pegasus0069/CogniLink/cognilink-journal-overleaf paper contents/figures/fig5e_hid_report_intervals.png

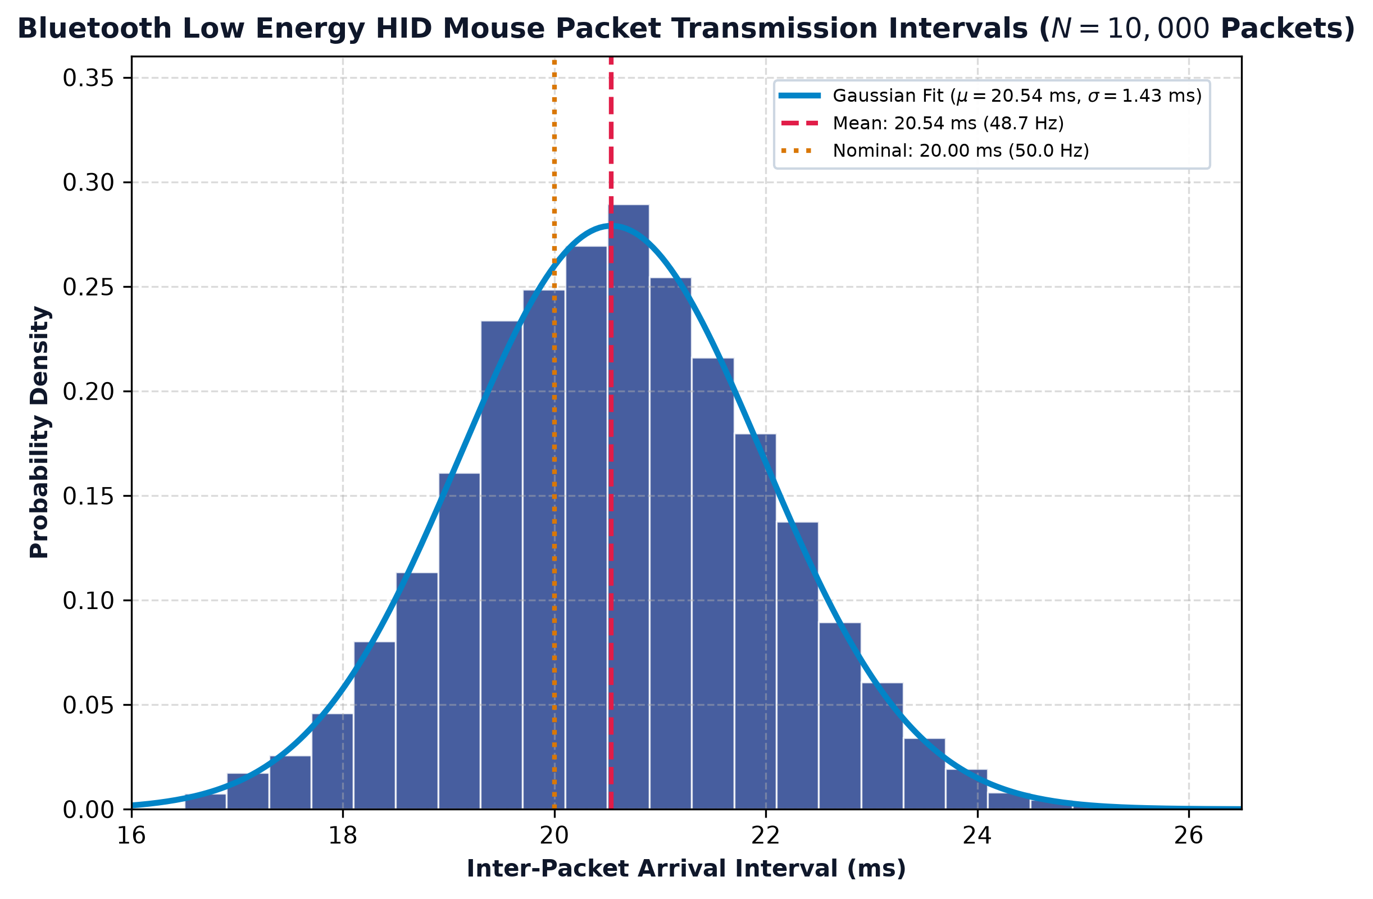
cognilink-journal-overleaf paper contents/figures/fig5e_hid_report_intervals.png
