pegasus0069/CogniLink/figures/assets/fig2_hardware_architecture_master.png

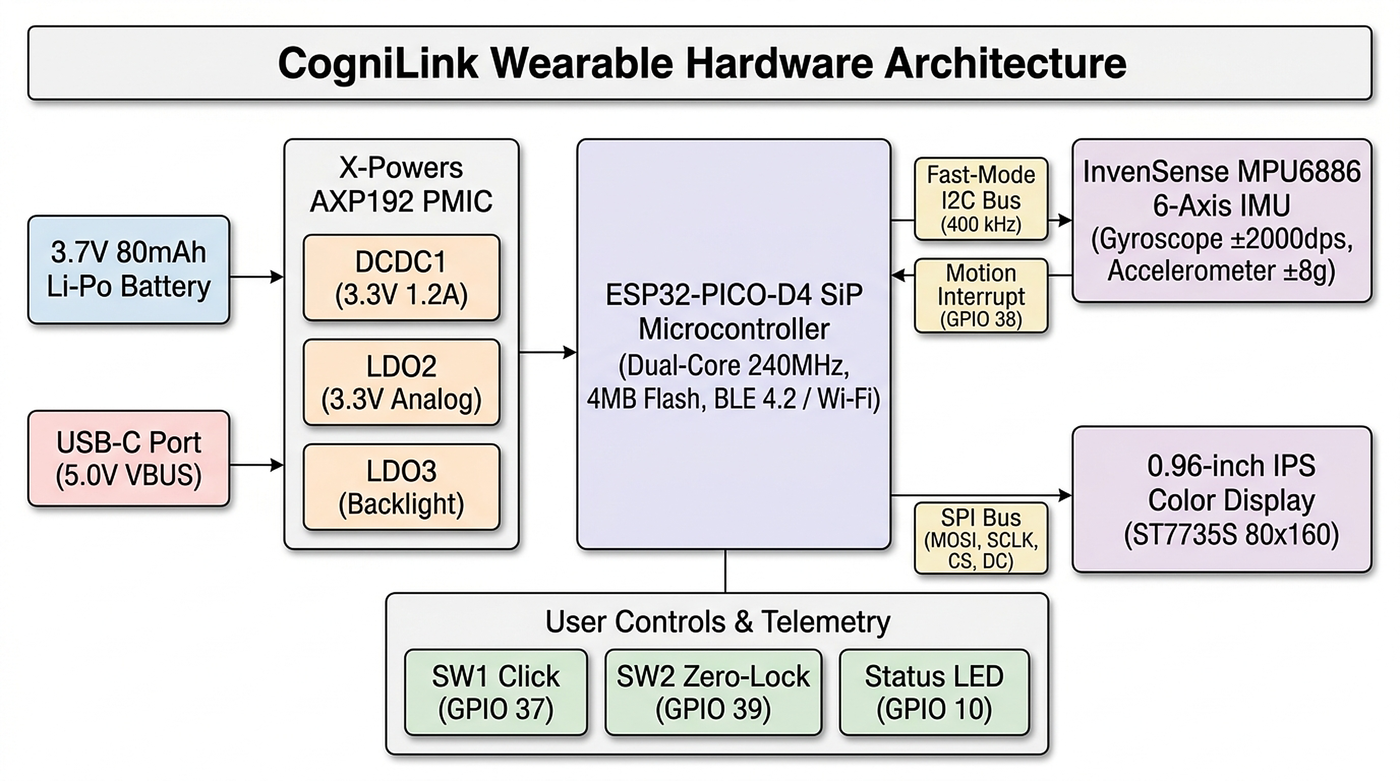
figures/assets/fig2_hardware_architecture_master.png
