pegasus0069/CogniLink/figures/assets/scratch_art_a.png

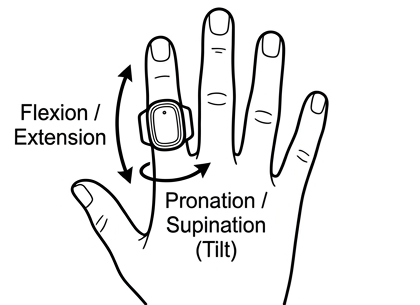
figures/assets/scratch_art_a.png
