pegasus0069/CogniLink/figures/assets/scratch_art_b.png

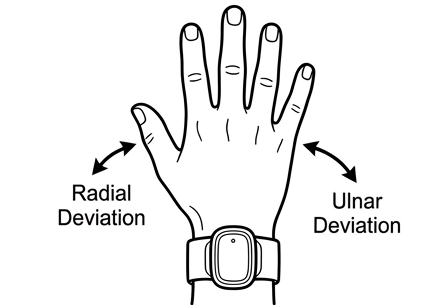
figures/assets/scratch_art_b.png
