pegasus0069/CogniLink/figures/assets/scratch_art_c.png

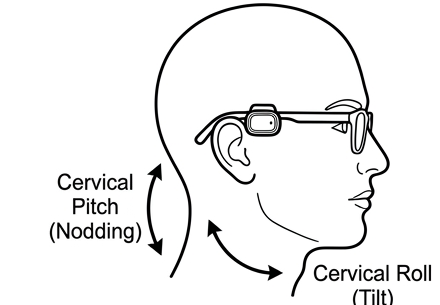
figures/assets/scratch_art_c.png
