pegasus0069/CogniLink/figures/assets/scratch_art_d.png

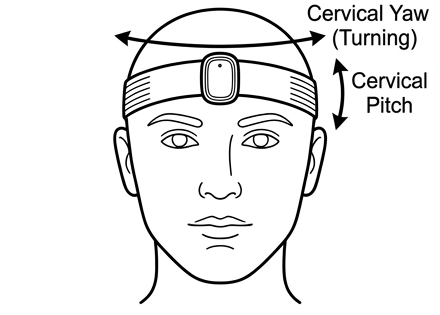
figures/assets/scratch_art_d.png
