pegasus0069/CogniLink/figures/assets/scratch_art_e.png

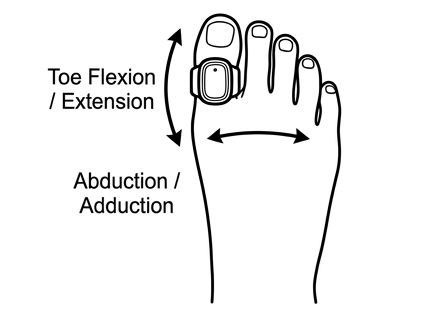
figures/assets/scratch_art_e.png
