pegasus0069/CogniLink/figures/fig5a_end_to_end_latency.png

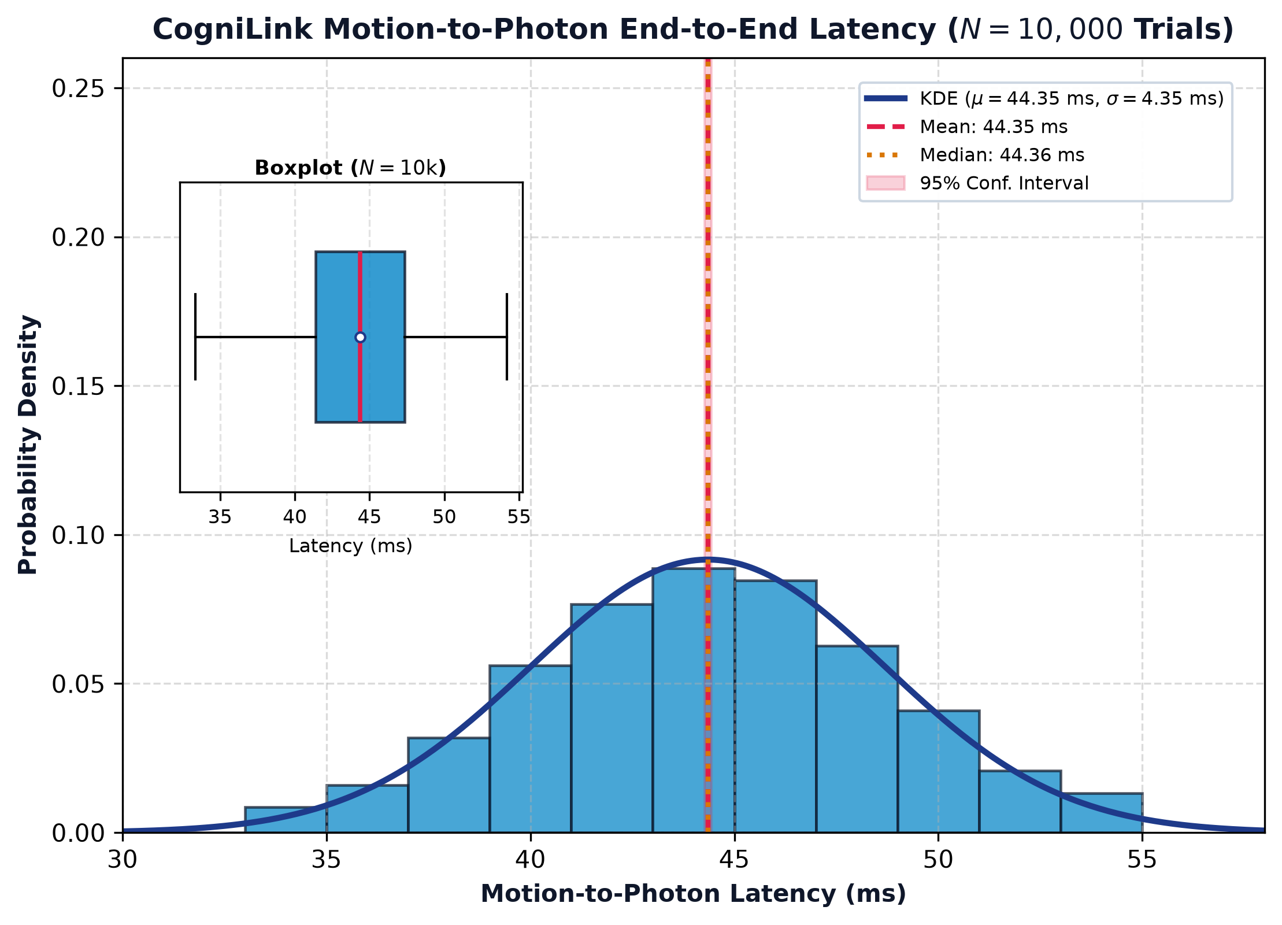
figures/fig5a_end_to_end_latency.png
