pegasus0069/CogniLink/figures/fig5b_stationary_drift.png

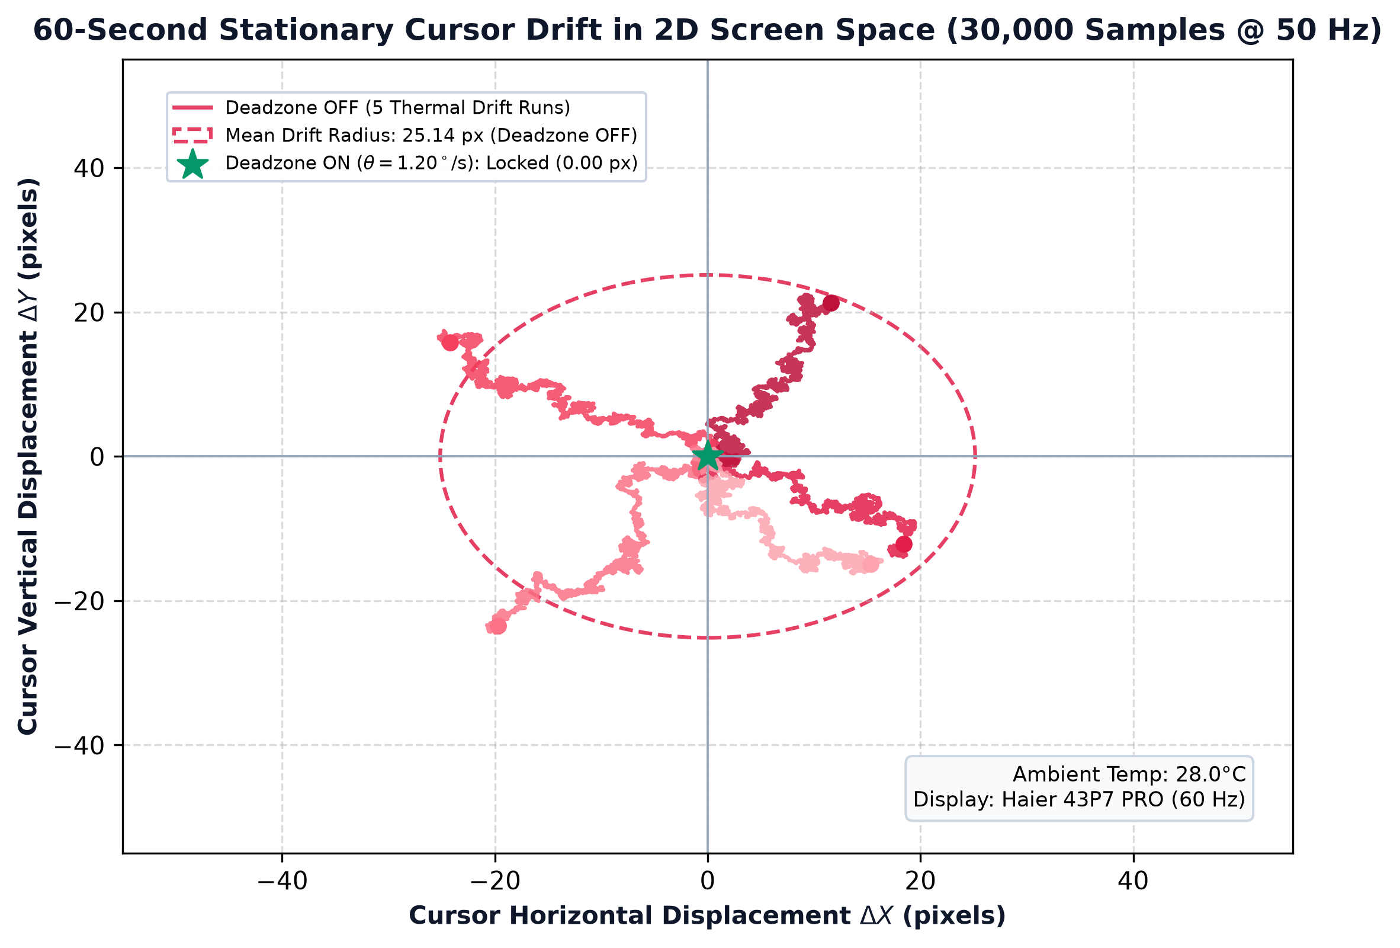
figures/fig5b_stationary_drift.png
