pegasus0069/CogniLink/figures/fig5c_dwell_timing_accuracy.png

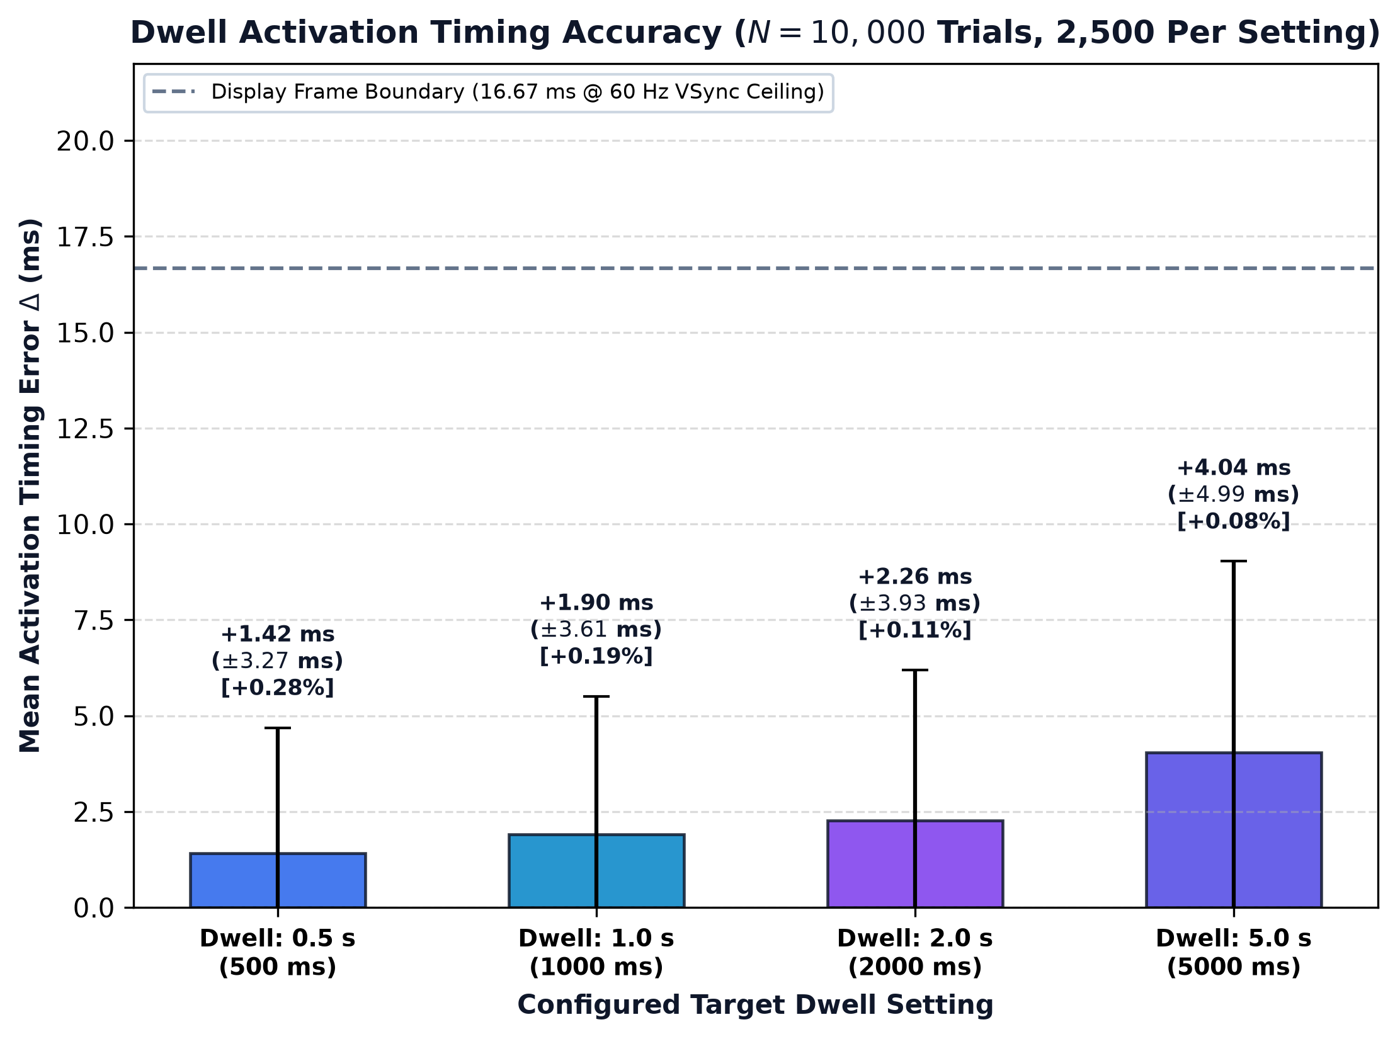
figures/fig5c_dwell_timing_accuracy.png
