pegasus0069/CogniLink/figures/m5stickc_photo.jpg

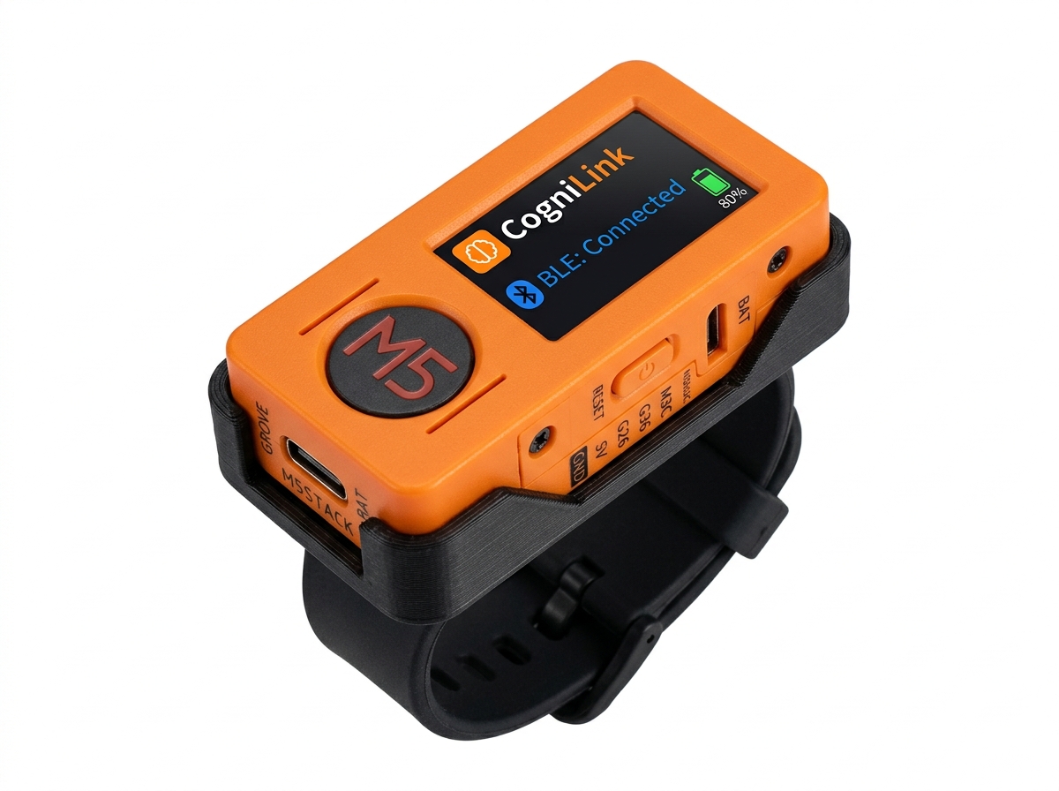
figures/m5stickc_photo.jpg
