pegasus0069/CogniLink/cad/stl/cognilink_eyeglass_temple_clip.stl

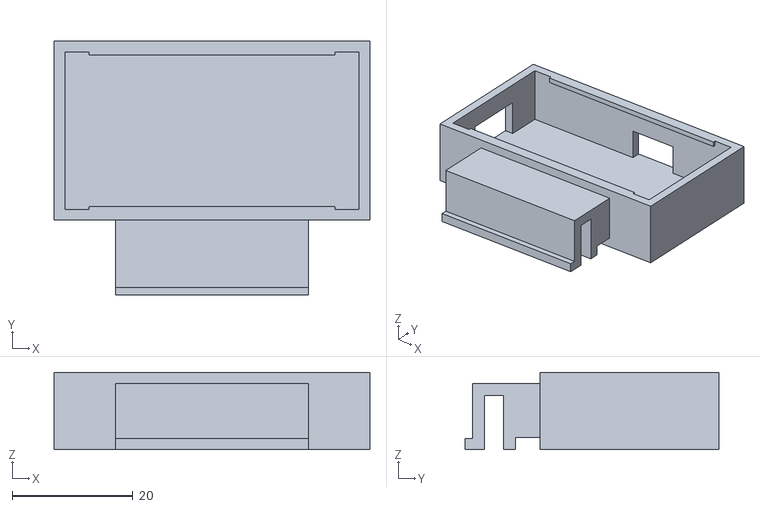
[picture p17: CAD file, 2026-10-24]
cad/stl/cognilink_eyeglass_temple_clip.stl
52.4 x 42.1 x 12.8
