pegasus0069/CogniLink/cad/stl/cognilink_hallux_toe_mount.stl

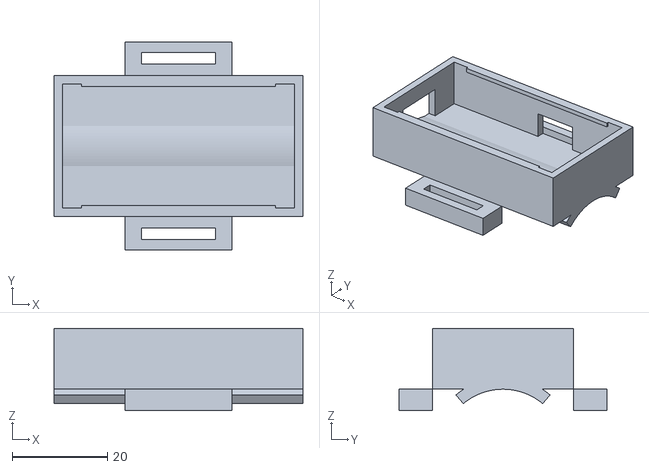
[picture p18: CAD file, 2026-10-24]
cad/stl/cognilink_hallux_toe_mount.stl
52.4 x 43.7 x 17.3
