pegasus0069/CogniLink/cad/stl/cognilink_finger_ring_cradle.stl

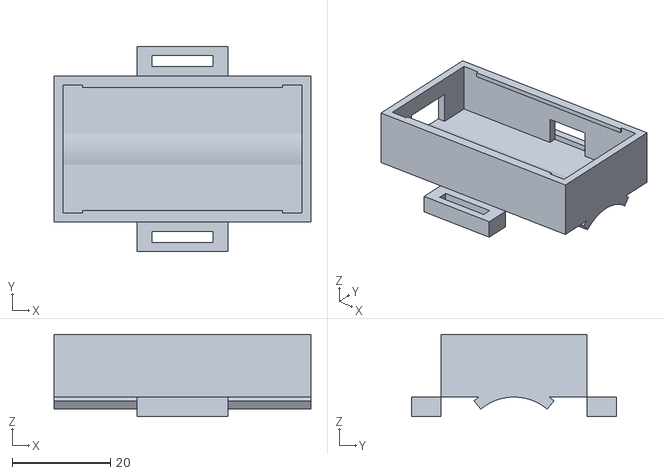
[picture p19: CAD file, 2026-10-24]
cad/stl/cognilink_finger_ring_cradle.stl
52.4 x 41.7 x 16.8
