pegasus0069/CogniLink/cad/stl/cognilink_wrist_mount_cradle.stl

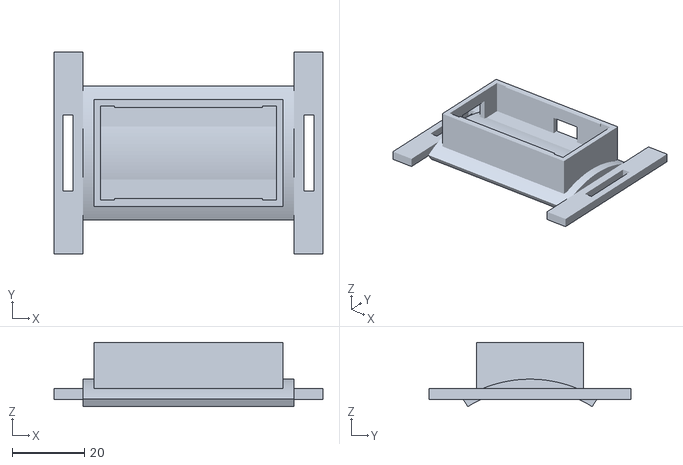
[picture p20: CAD file, 2026-10-24]
cad/stl/cognilink_wrist_mount_cradle.stl
74.4 x 56.0 x 17.8
