pegasus0069/CogniLink/cad/stl/cognilink_headband_mount_cradle.stl

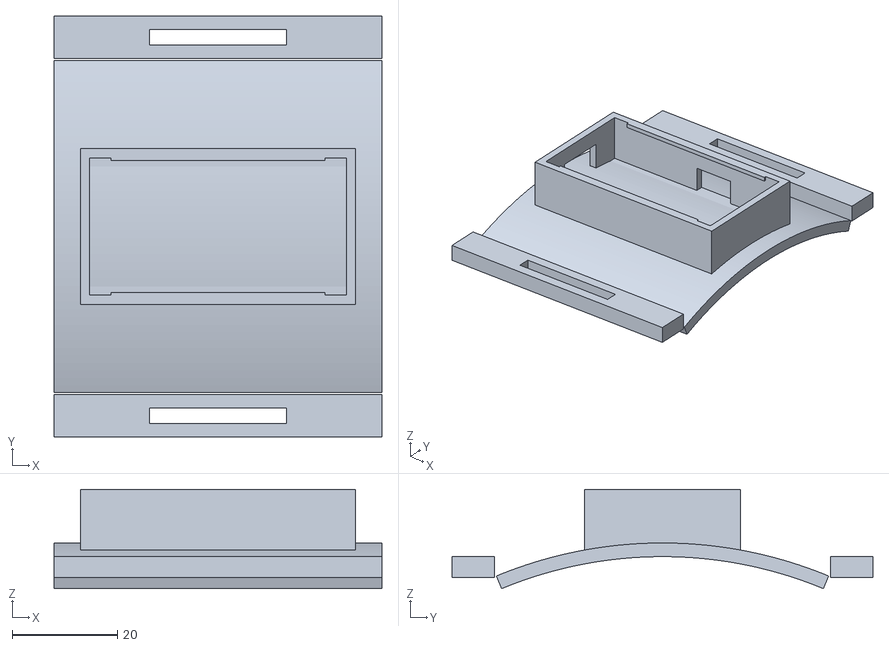
[picture p21: CAD file, 2026-10-24]
cad/stl/cognilink_headband_mount_cradle.stl
62.4 x 80.0 x 18.9
