pegasus0069/CogniLink/cad/stl/cognilink_universal_cradle.stl

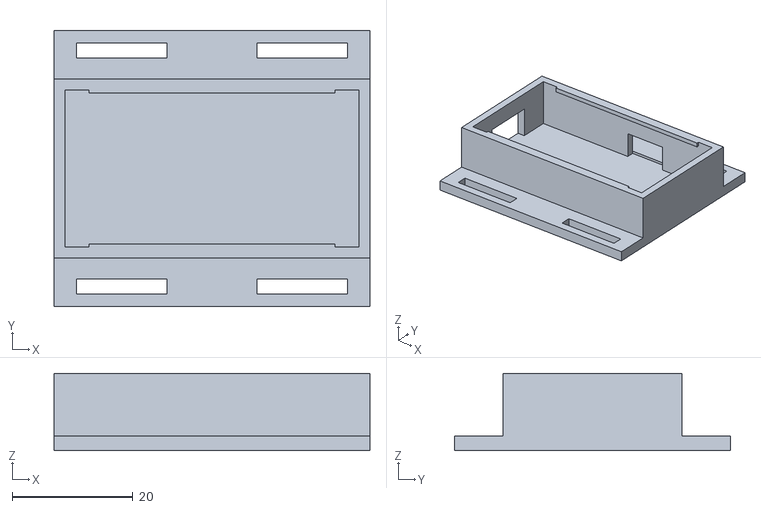
[picture p22: CAD file, 2026-10-24]
cad/stl/cognilink_universal_cradle.stl
52.4 x 45.7 x 12.8
