pegasus0069/CogniLink/(list of files, cad)

Other CAD files:
cad/openscad/cognilink_finger_ring.scad
