pegasus0069/CogniLink/figures/test_callouts.png

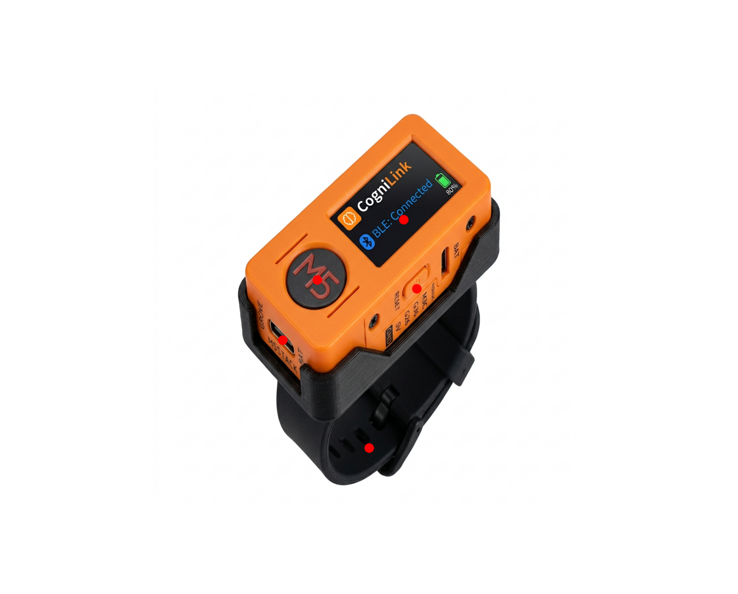
figures/test_callouts.png
