pegasus0069/CogniLink/cognilink-journal-overleaf paper contents/figures/fig5d_speech_onset_latency.png

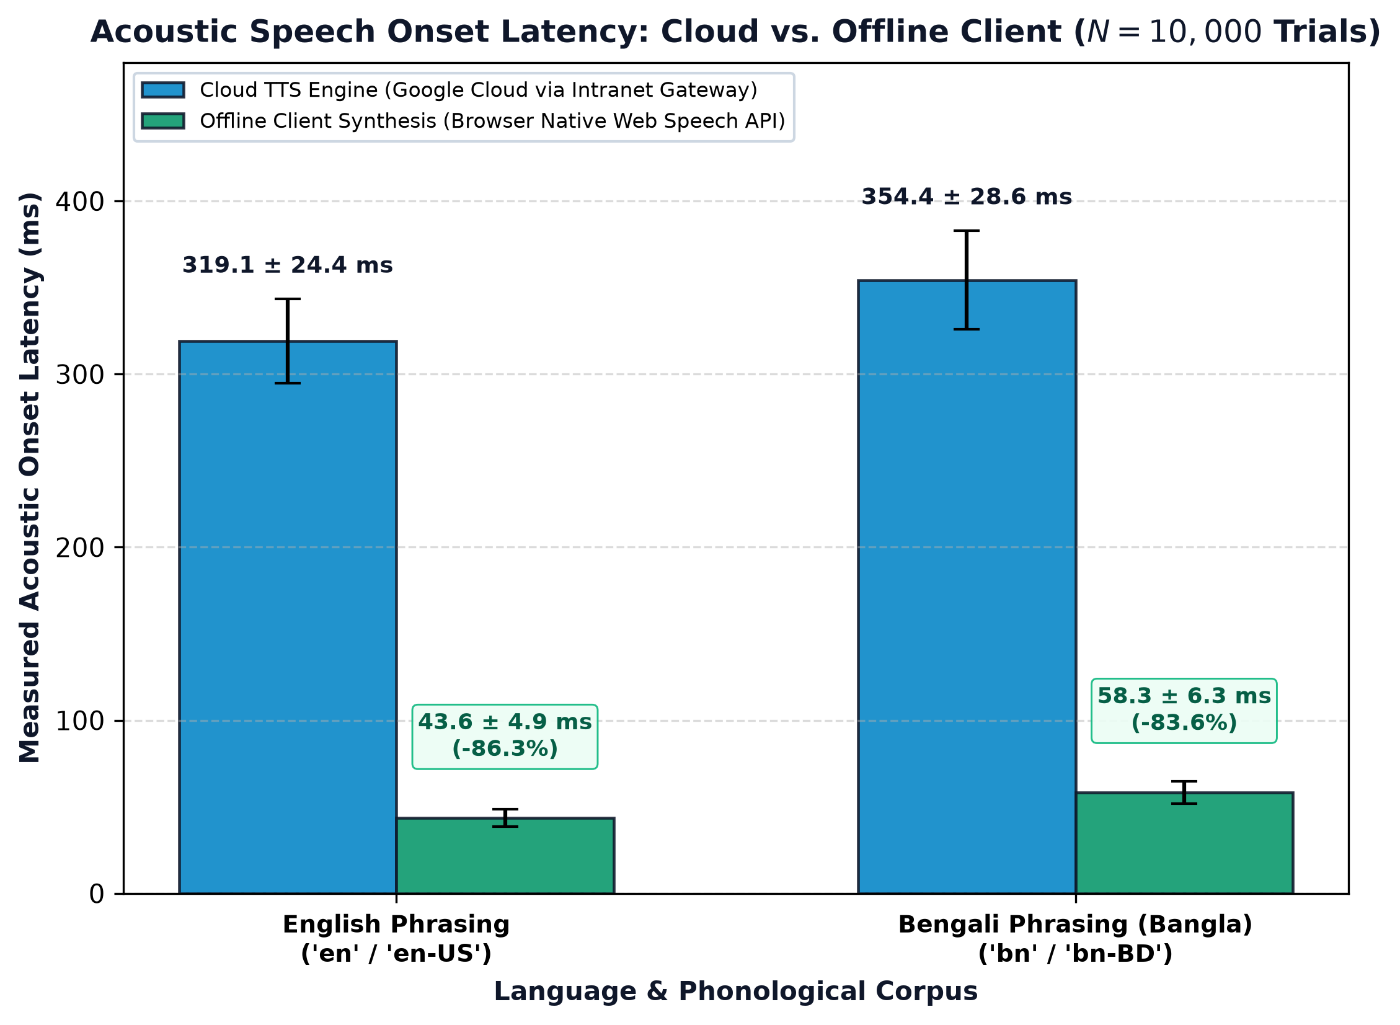
cognilink-journal-overleaf paper contents/figures/fig5d_speech_onset_latency.png
