pegasus0069/CogniLink/cognilink-journal-overleaf paper contents/rev2/figures/fig5f_battery_discharge.png

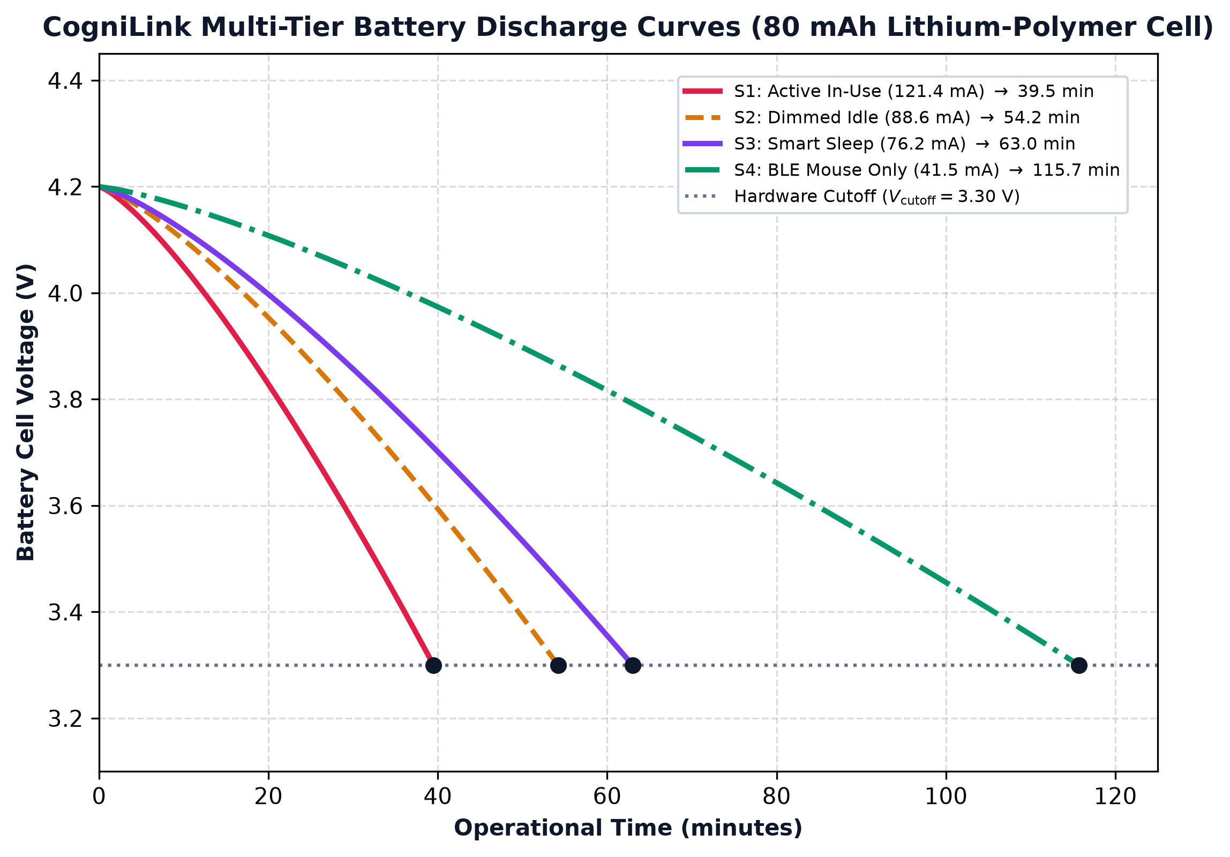
cognilink-journal-overleaf paper contents/rev2/figures/fig5f_battery_discharge.png
