pegasus0069/CogniLink/cognilink-journal-overleaf paper contents/rev2/figures/bengali_keyboard.pdf

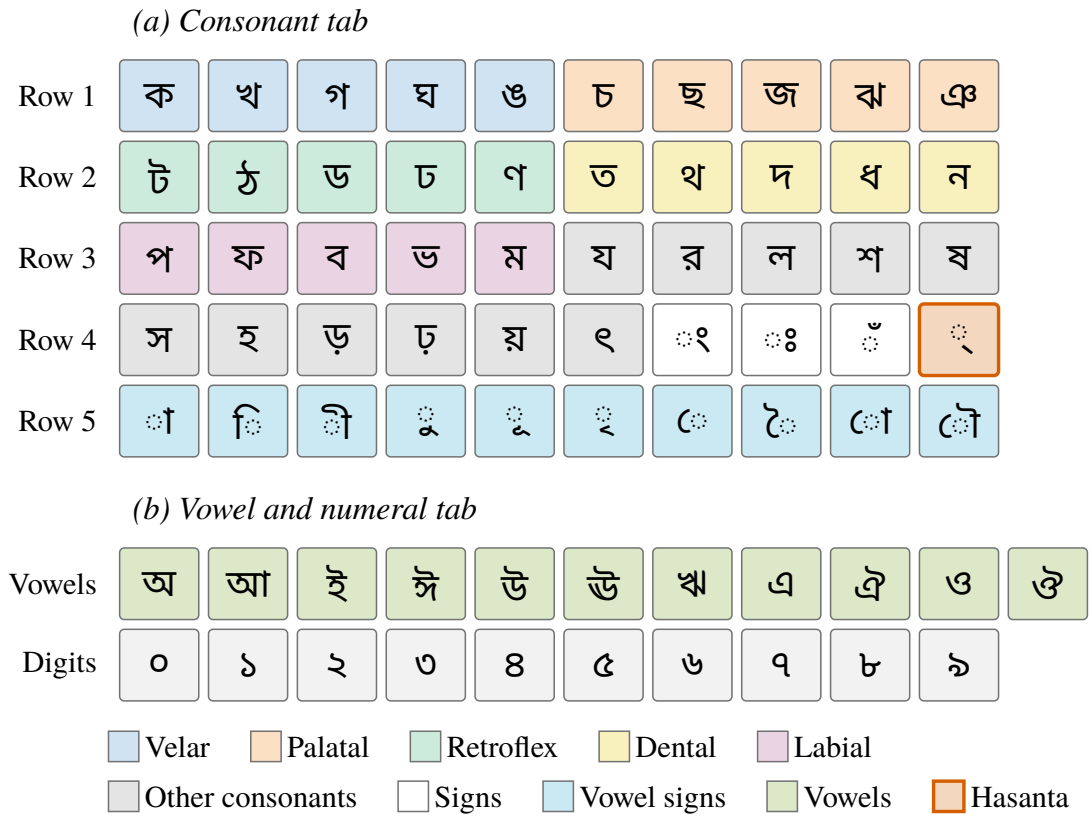
[picture p46: page 1]
(a) Consonant tab; Row 1; Row 2; Row 3; Row 4; Row 5; Vowels; Digits; Velar; Palatal; Retroflex; Dental; Labial; Other consonants; Signs; Vowel signs; Hasanta

(b) Vowel and numeral tab
