pegasus0069/CogniLink/(commit log)

2026-10-14 Paper material
2026-10-24 Add 3D CAD cradle models, update Overleaf paper manuscript, and align figures
2026-10-24 Update Overleaf README.txt with current figures, benchmarks, and manuscript status
