pegasus0069/CogniLink/(notices)

Notices in the files:
README.md:
License: GPLv3
